CularS/NanoVoltmeter/README.md

# NanoVoltmeter
Low and high input resistance nanovoltmeter with 20 and 200 mV range
