CularS/NanoVoltmeter/InitialConcepts/nanovoltmeter_dig.pdf

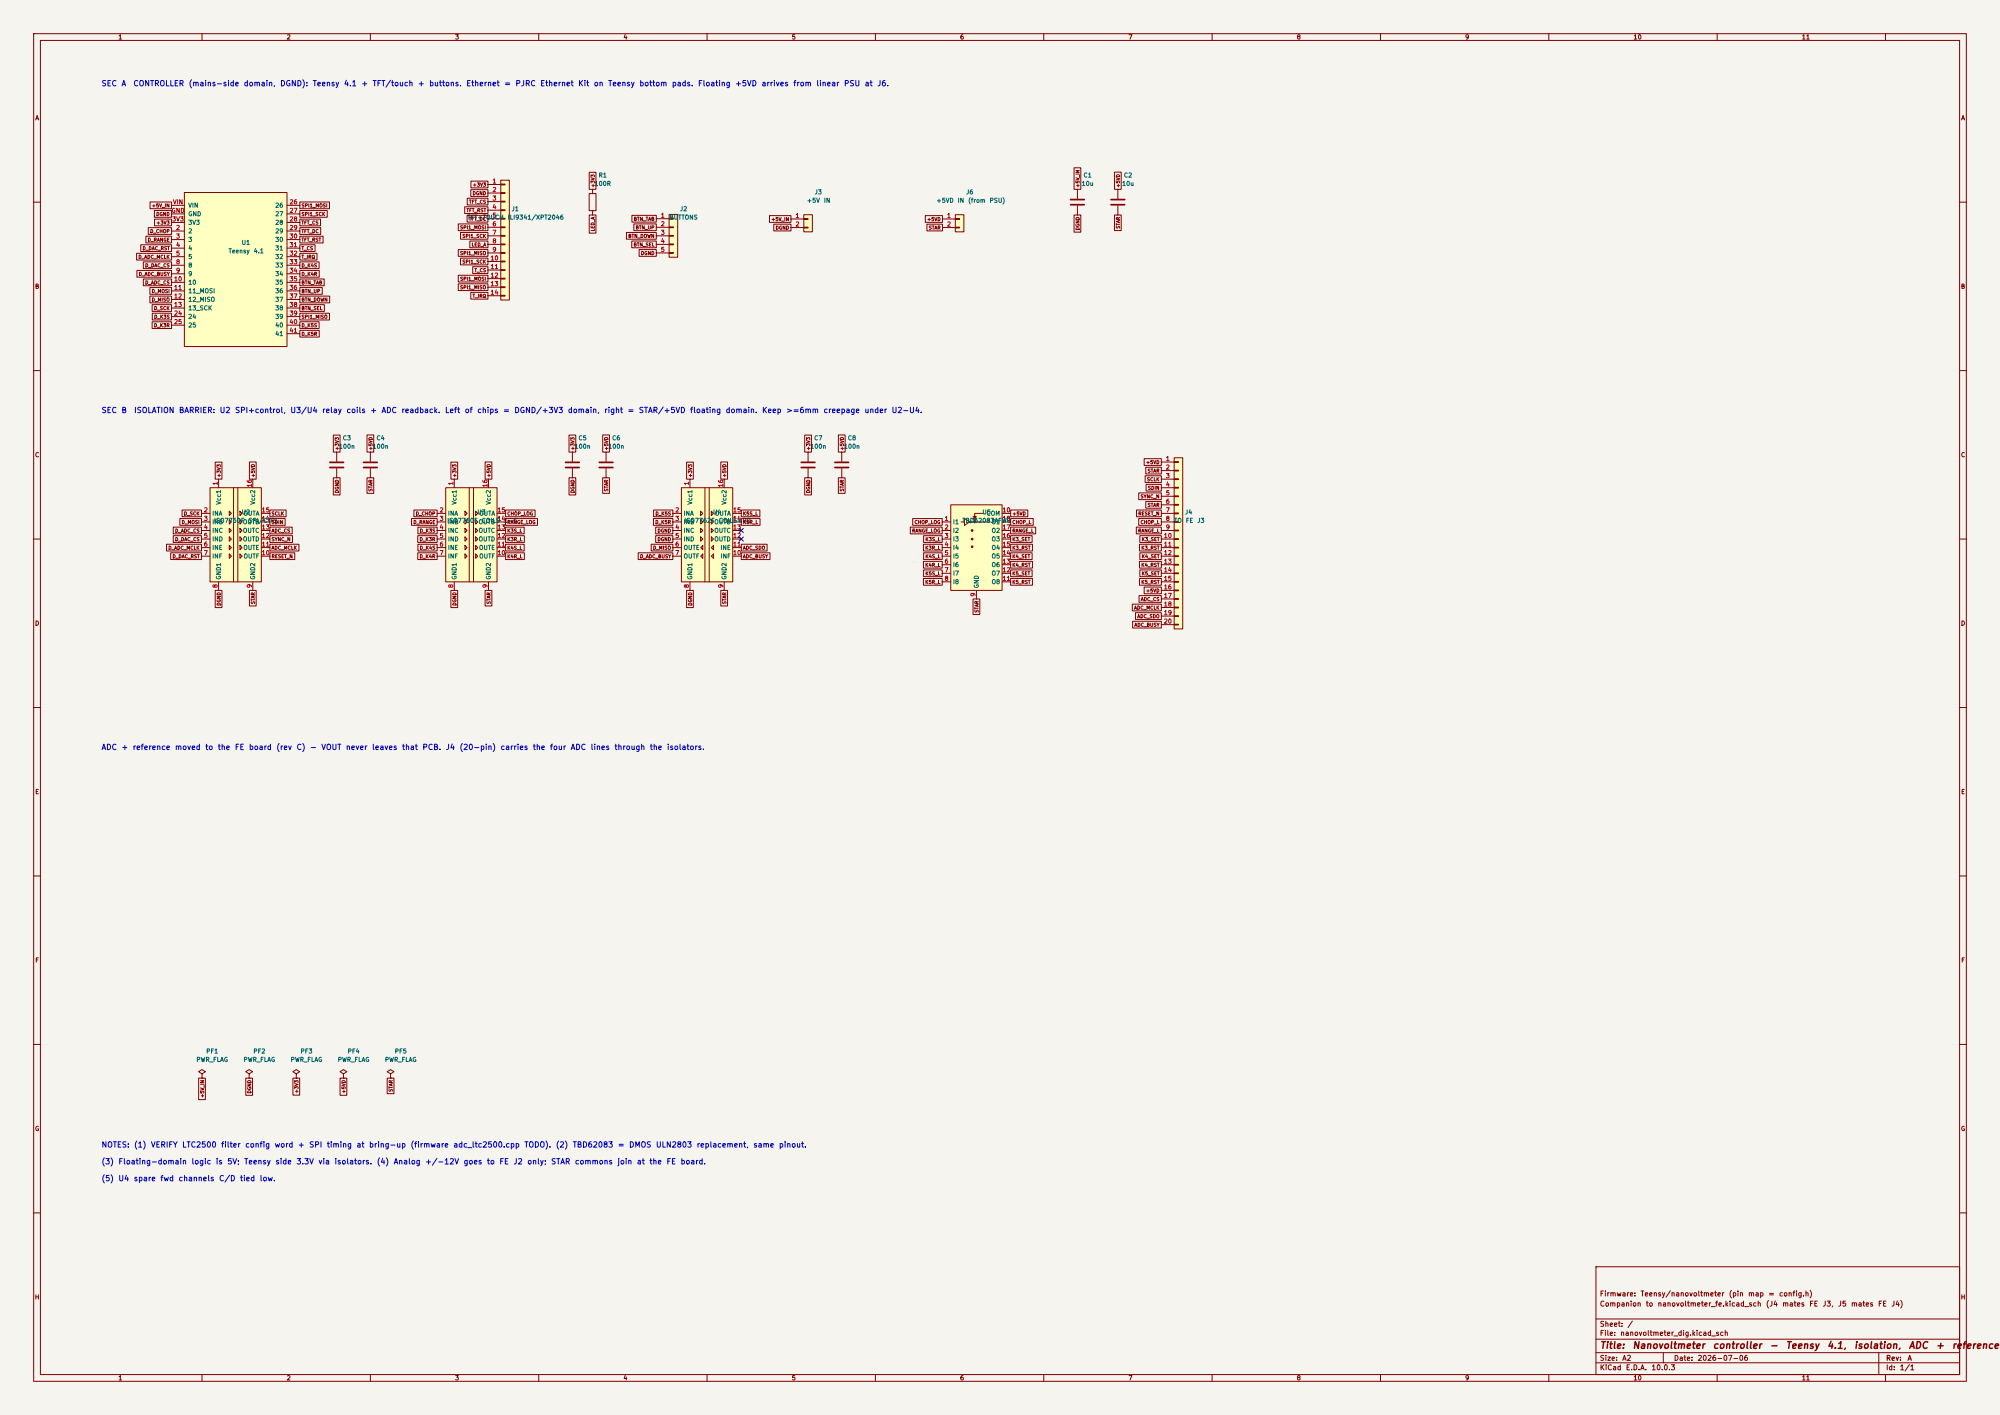
[picture p1: page 1]

SEC A CONTROLLER (mains-side domain, DGND): Teensy 4.1 + TFT/touch + buttons. Ethernet = PJRC Ethernet Kit on Teensy bottom pads. Floating +5VD arrives from linear PSU at J6.

SEC B ISOLATION BARRIER: U2 SPI+control, U3/U4 relay coils + ADC readback. Left of chips = DGND/+3V3 domain, right = STAR/+5VD floating domain. Keep >=6mm creepage under U2-U4.

9 OUTF 10 OUTE 11 OUTD 12 OUTC 13 OUTB 14 OUTA 15 Vcc2 16 U2

9 OUTF 10 OUTE 11 OUTD 12 OUTC 13 OUTB 14 OUTA 15 Vcc2 16 U3

INF 10 INE 11 OUTD 12 OUTC 13 OUTB 14 OUTA 15 Vcc2 16 U4

K5_RST K5_SET K4_RST NOTES: (1) VERIFY LTC2500 filter config word + SPI timing at bring-up (firmware adc_ltc2500.cpp TODO). (2) TBD62083 = DMOS ULN2803 replacement, same pinout.

ADC + reference moved to the FE board (rev C) - VOUT never leaves that PCB. J4 (20-pin) carries the four ADC lines through the isolators.

Firmware: Teensy/nanovoltmeter (pin map = config.h) PF3 PWR_FLAG

(3) Floating-domain logic is 5V; Teensy side 3.3V via isolators. (4) Analog +/-12V goes to FE J2 only; STAR commons join at the FE board.

(5) U4 spare fwd channels C/D tied low.

Companion to nanovoltmeter_fe.kicad_sch (J4 mates FE J3, J5 mates FE J4)

Sheet: /
File: nanovoltmeter_dig.kicad_sch
Title: Nanovoltmeter controller - Teensy 4.1, isolation, ADC + reference

Size: A2 | Rev: A
KiCad E.D.A. 10.0.3 | Id: 1/1
