CularS/NanoVoltmeter/InitialConcepts/nanovoltmeter_fe.pdf

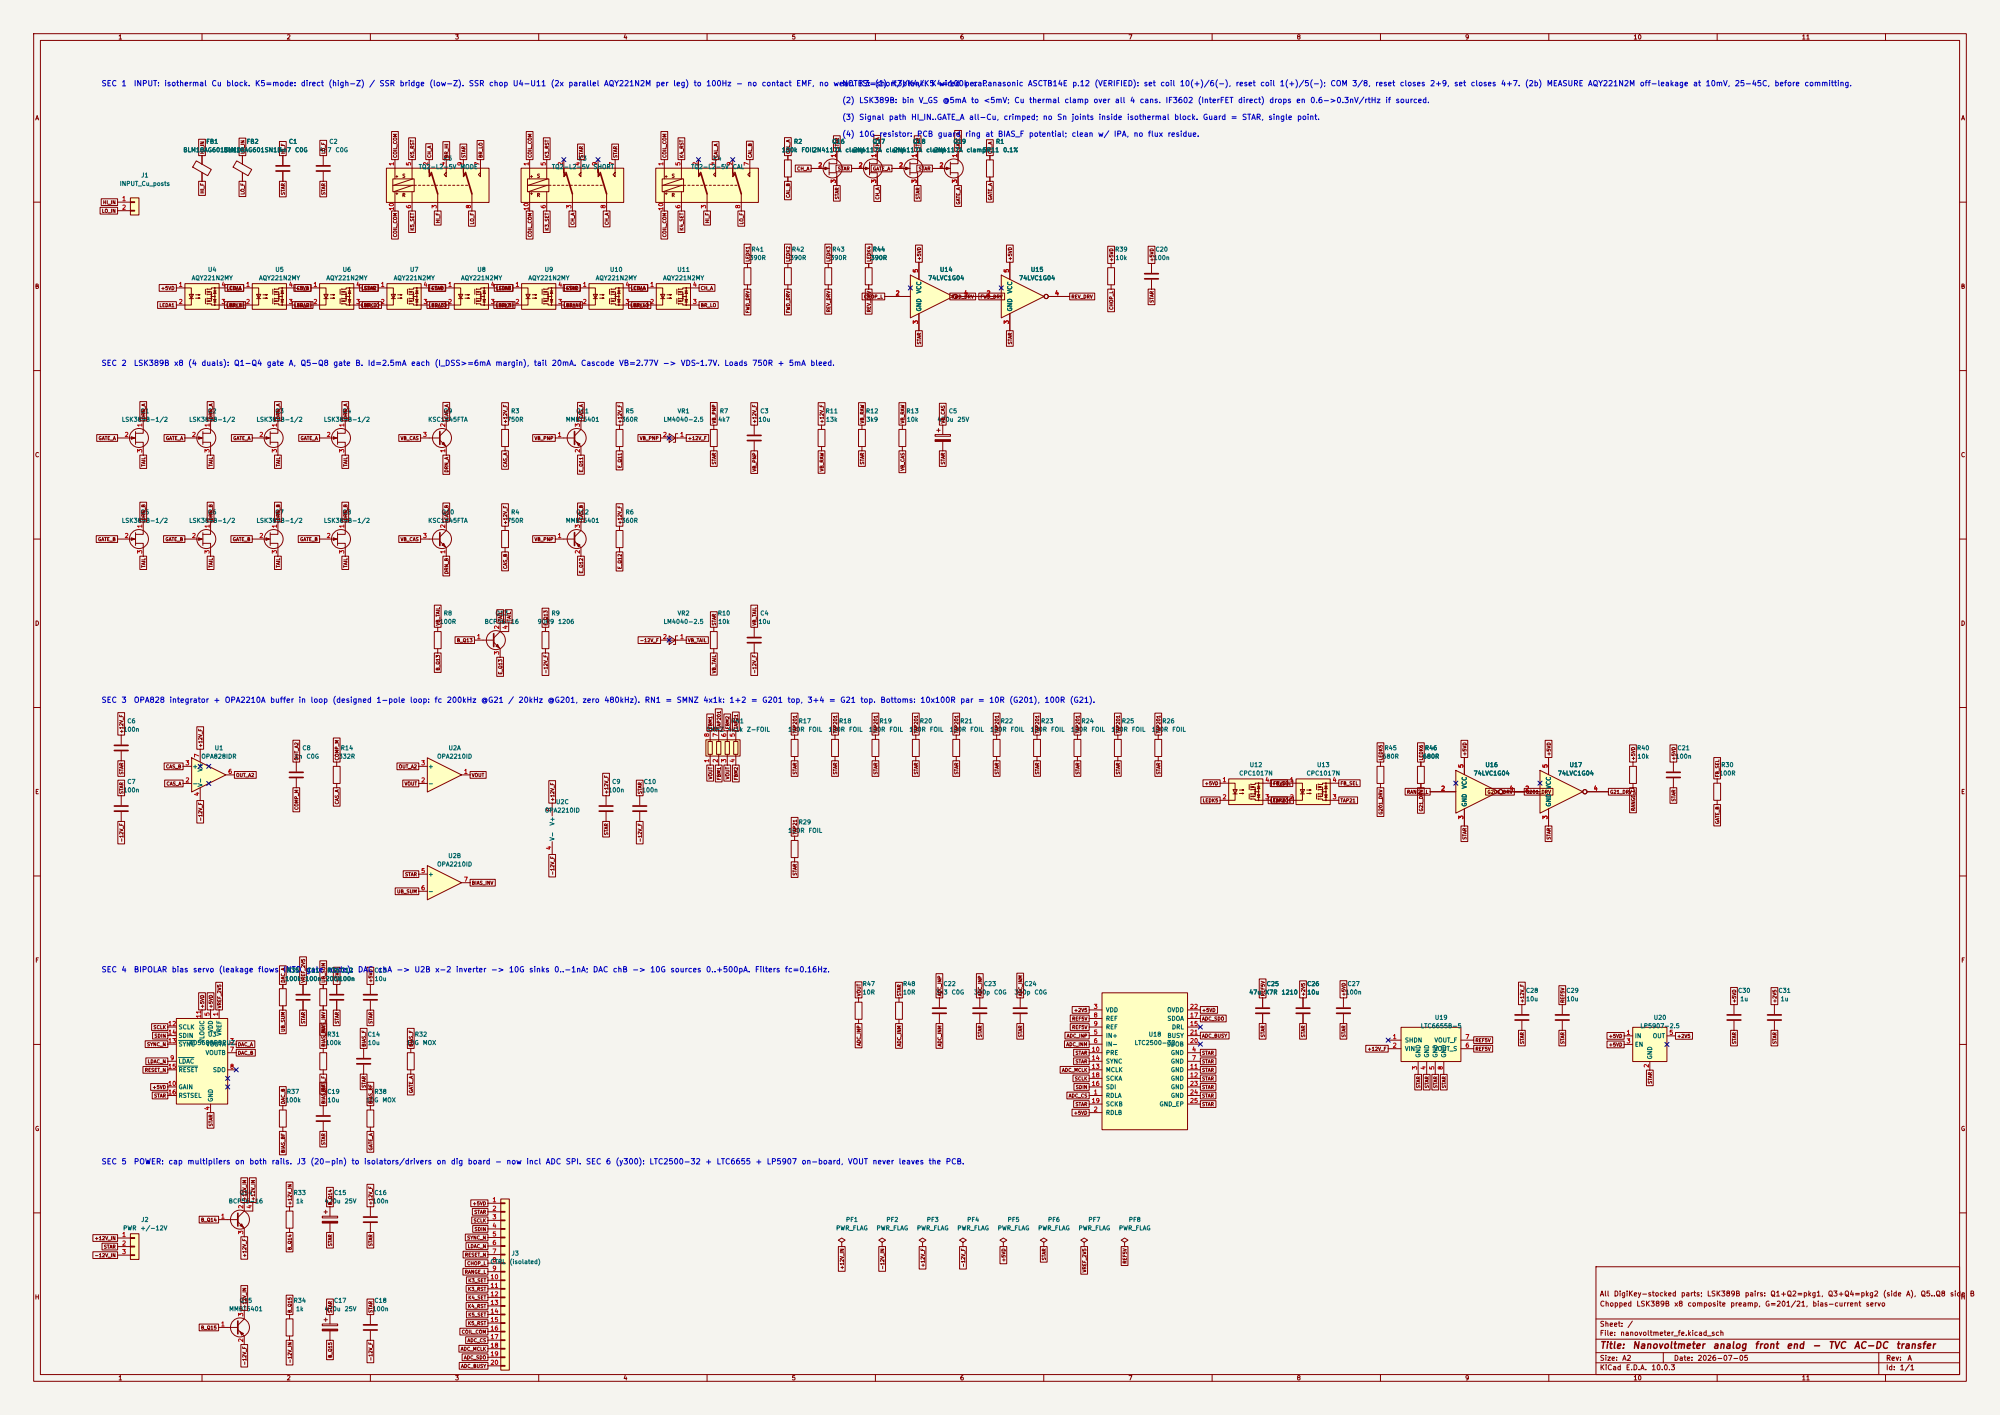
[picture p2: page 1]

SEC 1 INPUT: isothermal Cu block. K5=mode: direct (high-Z) / SSR bridge (low-Z). SSR chop U4-U11 (2x parallel AQY221N2M per leg) to 100Hz - no contact EMF, no wear. K3=short/blank. K4=100k cal.

NOTES: (1) K3/K4/K5 wired per Panasonic ASCTB14E p.12 (VERIFIED): set coil 10(+)/6(-), reset coil 1(+)/5(-); COM 3/8, reset closes 2+9, set closes 4+7. (2b) MEASURE AQY221N2M off-leakage at 10mV, 25-45C, before committing.
74LVC1G04 R1

(2) LSK389B: bin V_GS @5mA to <5mV; Cu thermal clamp over all 4 cans. IF3602 (InterFET direct) drops en 0.6->0.3nV/rtHz if sourced.

(3) Signal path HI_IN..GATE_A all-Cu, crimped; no Sn joints inside isothermal block. Guard = STAR, single point.

SEC 2 LSK389B x8 (4 duals): Q1-Q4 gate A, Q5-Q8 gate B. Id=2.5mA each (I_DSS>=6mA margin), tail 20mA. Cascode VB=2.77V -> VDS~1.7V. Loads 750R + 5mA bleed.

SEC 5 POWER: cap multipliers on both rails. J3 (20-pin) to isolators/drivers on dig board - now incl ADC SPI. SEC 6 (y300): LTC2500-32 + LTC6655 + LP5907 on-board, VOUT never leaves the PCB.

All DigiKey-stocked parts; LSK389B pairs: Q1+Q2=pkg1, Q3+Q4=pkg2 (side A), Q5..Q8 side B
Chopped LSK389B x8 composite preamp, G=201/21, bias-current servo

Sheet: /
File: nanovoltmeter_fe.kicad_sch
Title: Nanovoltmeter analog front end - TVC AC-DC transfer
KiCad E.D.A. 10.0.3
