CularS/NanoVoltmeter/NVM_FrontEnd_v1/NVM_FrontEnd_v1.kicad_pcb

## KiCad design NVM_FrontEnd_v1/NVM_FrontEnd_v1.kicad_pcb (2026-07-14)

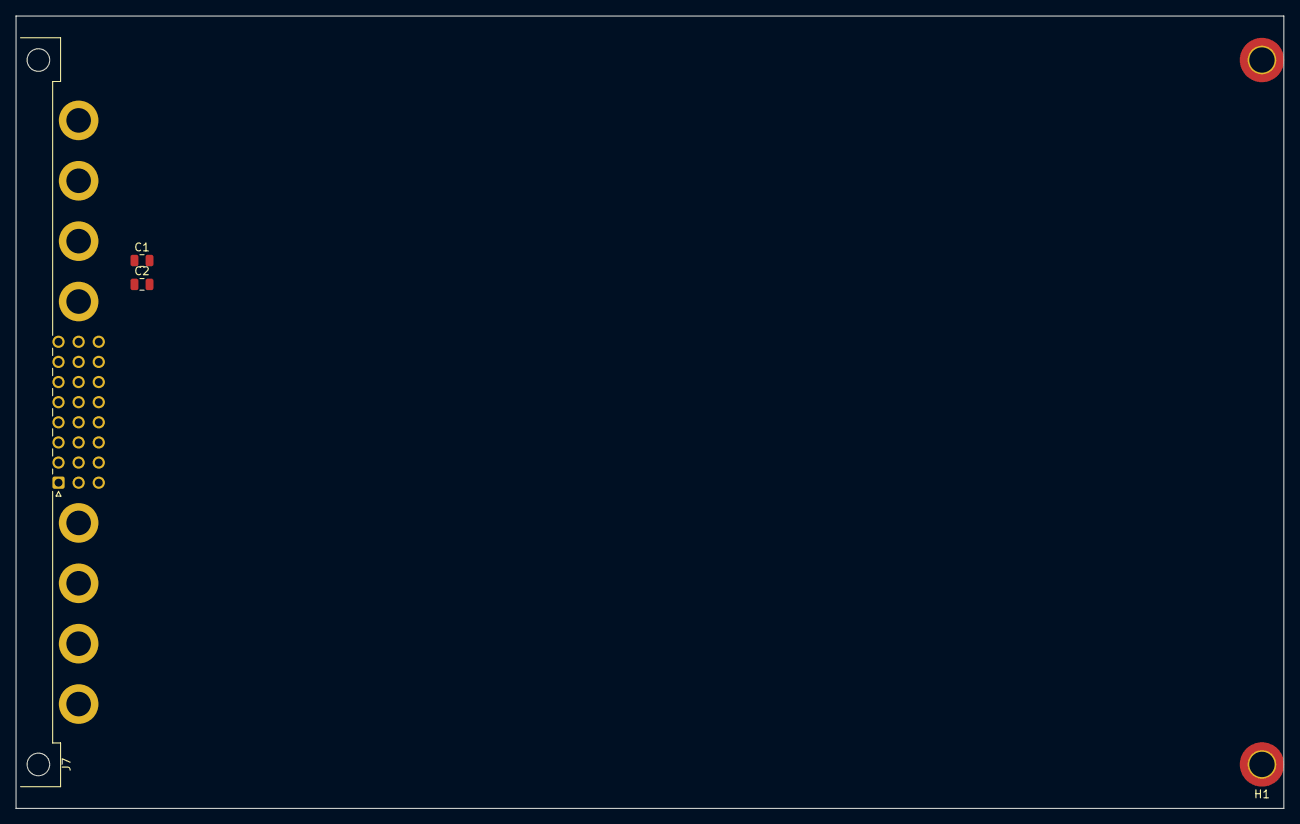
[picture p4: board NVM_FrontEnd_v1.kicad_pcb from above]

Board: 2 copper layers, 160.0 x 100.0 mm, 5 parts (0 on the bottom side), 5 nets, no tracks yet.

Parts:
C1, C2: 10u; C_0805_2012Metric
H1, H3: MountingHole_Pad; MountingHole_3.2mm_M3_DIN965_Pad_TopBottom
J7: DIN41612_M_3x8+8_Power_Male; DIN41612_M_3x8+8_Male_Horizontal_THT_Power

Connections:
+5V_An: C2.1, J7.P3
+5V_Dig: C1.1, J7.P7
DGND: C1.2, J7.P6, J7.P8
Earth: H1.1 (1_1), H3.1 (1_1)
STAR: C2.2, J7.P2, J7.P5
