CularS/NanoVoltmeter/NVM_Digital_v1/NVM_Digital_v1.kicad_pcb

## KiCad design NVM_Digital_v1/NVM_Digital_v1.kicad_pcb (2026-07-08)

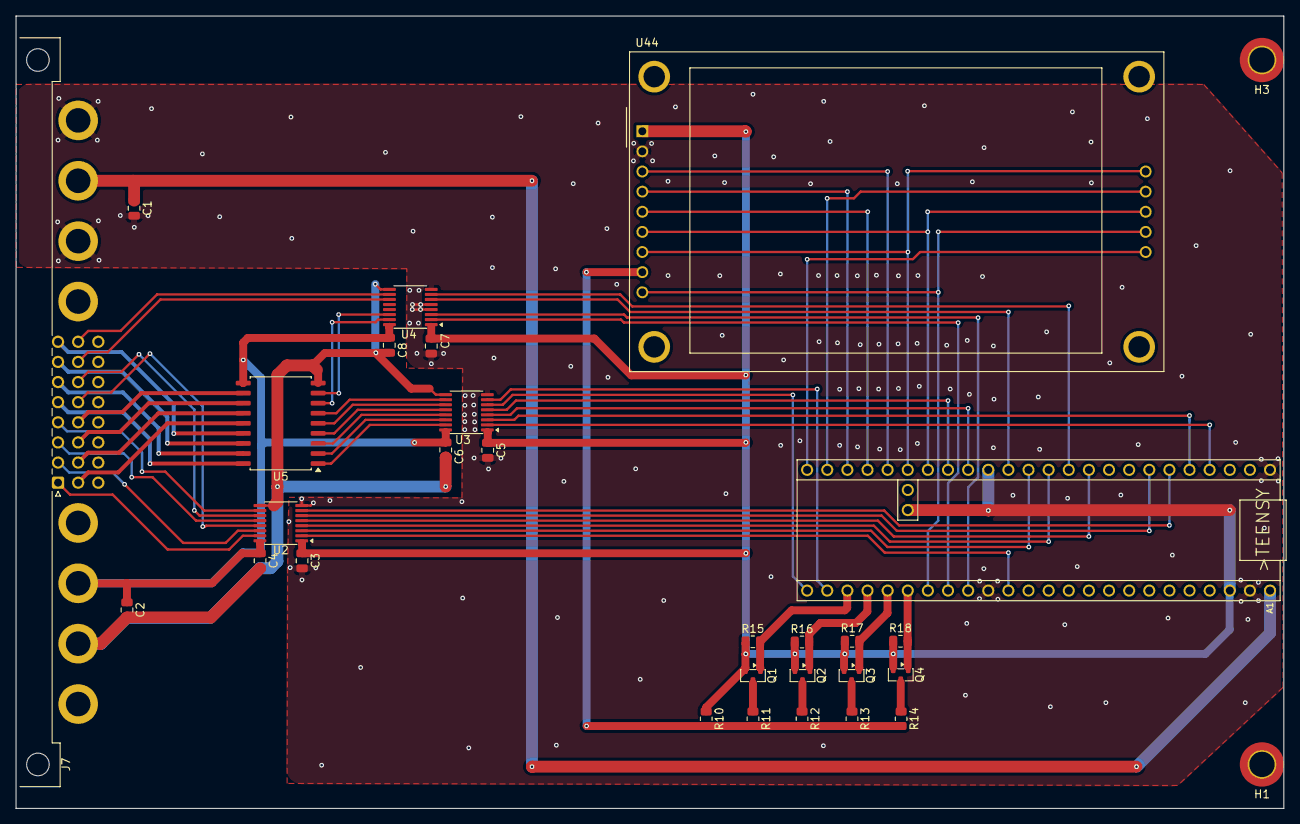
[picture p5: board NVM_Digital_v1.kicad_pcb from above]

Board: 2 copper layers, 160.0 x 100.0 mm, 30 parts (0 on the bottom side), 63 nets.

Parts:
A1: TEENSY_4.1; TEENSY_LONG_EXT
C1, C2: 10u; C_0805_2012Metric
C3, C4, C5, C6, C7, C8: 100n; C_0805_2012Metric
H1, H3: MountingHole_Pad; MountingHole_3.2mm_M3_DIN965_Pad_TopBottom
J7: DIN41612_M_3x8+8_Power_Male; DIN41612_M_3x8+8_Male_Horizontal_THT_Power
Q1, Q2, Q3, Q4: DMG3415U; SOT-23
R10: 330R; R_0805_2012Metric
R11: 150R; R_0805_2012Metric
R12: 68R; R_0805_2012Metric
R13: 33R; R_0805_2012Metric
R14: 15R; R_0805_2012Metric
R15, R16, R17, R18: 100k; R_0805_2012Metric
U2: ISO7760F SPI/CTRL; QSOP-16_3.9x4.9mm_P0.635mm
U3: ISO7760F COILS 1-6; QSOP-16_3.9x4.9mm_P0.635mm
U4: ISO7762F COILS+RD; QSOP-16_3.9x4.9mm_P0.635mm
U5: TBD62083AFWG; SOP-18_7.495x11.515mm_P1.27mm
U44: CR2013-MI2120

Connections:
+3V3: A1.3V3 (3.3V), A1.3V3@2 (3.3V), A1.3V3@3 (3.3V), C3.1, C5.1, C7.1, Q1.2 (S), Q2.2 (S), Q3.2 (S), Q4.2 (S), R10.1, R15.1, R16.1, R17.1, R18.1, U2.1 (Vcc1), U3.1 (Vcc1), U4.1 (Vcc1), U44.1 (VCC)
+5V_An: C2.1, C4.1, C6.1, C8.1, J7.P3, U2.16 (Vcc2), U3.16 (Vcc2), U4.16 (Vcc2), U5.10 (COM)
+5V_Dig: A1.VIN, C1.1, J7.P7
ADC_BUSY: J7.b20, U4.10 (INF)
ADC_CS: J7.b17, U2.13 (OUTC)
ADC_MCLK: J7.b18, U2.11 (OUTE)
ADC_SDO: J7.b19, U4.11 (INE)
CHOP_L: J7.a17, U5.18 (O1)
CHOP_LOG: U3.15 (OUTA), U5.1 (I1)
DGND: A1.AGND/GND (GND), A1.GND, A1.GND@2 (GND), C1.2, C3.2, C5.2, C7.2, J7.P6, J7.P8, U2.8 (GND1), U3.8 (GND1), U4.4 (INC), U4.5 (IND), U4.8 (GND1), U44.2 (GND)
D_ADC_BUSY: A1.D9, U4.7 (OUTF)
D_ADC_CS: A1.D10 ((CS)D10), U2.4 (INC)
D_ADC_MCLK: A1.D5, U2.6 (INE)
D_BL1: A1.D35, Q1.1 (G), R15.2
D_BL2: A1.D36, Q2.1 (G), R16.2
D_BL3: A1.D37, Q3.1 (G), R17.2
D_BL4: A1.D38 (A14), Q4.1 (G), R18.2
D_CHOP: A1.D2, U3.2 (INA)
D_DAC_CS: A1.D8, U2.5 (IND)
D_DAC_RST: A1.D4, U2.7 (INF)
D_K3R: A1.D25 (A11), U3.5 (IND)
D_K3S: A1.D24 (A10), U3.4 (INC)
D_K4R: A1.D34, U3.7 (INF)
D_K4S: A1.D33, U3.6 (INE)
D_K5R: A1.D41 (A17), U4.3 (INB)
D_K5S: A1.D40 (A16), U4.2 (INA)
D_MISO: A1.D12 ((SDI)D12), U4.6 (OUTE)
D_MOSI: A1.D11 ((SDO)D11), U2.3 (INB)
D_RANGE: A1.D3, U3.3 (INB)
D_SCK: A1.D13 ((CLK)D13), U2.2 (INA)
Earth: H1.1 (1_1), H3.1 (1_1)
K3R_L: U3.12 (OUTD), U5.4 (I4)
K3S_L: U3.13 (OUTC), U5.3 (I3)
K3_RST: J7.a20, U5.15 (O4)
K3_SET: J7.a19, U5.16 (O3)
K4R_L: U3.10 (OUTF), U5.6 (I6)
K4S_L: U3.11 (OUTE), U5.5 (I5)
K4_RST: J7.b14, U5.13 (O6)
K4_SET: J7.b13, U5.14 (O5)
K5R_L: U4.14 (OUTB), U5.8 (I8)
K5S_L: U4.15 (OUTA), U5.7 (I7)
K5_RST: J7.b16, U5.11 (O8)
K5_SET: J7.b15, U5.12 (O7)
unnamed: Q1.3 (D), R11.1
unnamed: Q2.3 (D), R12.1
unnamed: Q3.3 (D), R13.1
unnamed: Q4.3 (D), R14.1
unnamed: R10.2, R11.2, R12.2, R13.2, R14.2, U44.8 (LED)
RANGE_L: J7.a18, U5.17 (O2)
RANGE_LOG: U3.14 (OUTB), U5.2 (I2)
RESET_N: J7.a16, U2.10 (OUTF)
SCLK: J7.a13, U2.15 (OUTA)
SDIN: J7.a14, U2.14 (OUTB)
SPI1_MISO: A1.D39 (A15), U44.9 (MISO), U44.13 (T_DO)
SPI1_MOSI: A1.D26 (A12), U44.6 (MOSI), U44.12 (T_DIN)
SPI1_SCK: A1.D27 (A13), U44.7 (SCK), U44.10 (T_CLK)
STAR: C2.2, C4.2, C6.2, C8.2, J7.P2, J7.P5, U2.9 (GND2), U3.9 (GND2), U4.9 (GND2), U5.9 (GND)
SYNC_N: J7.a15, U2.12 (OUTD)
TFT_CS: A1.D28, U44.3 (~CS)
TFT_DC: A1.D29, U44.5 (D/~C)
TFT_RST: A1.D30, U44.4 (RESET)
T_CS: A1.D31, U44.11 (T_CS)
T_IRQ: A1.D32, U44.14 (T_IRQ)
