CularS/NanoVoltmeter/NVM_PSU_v1/NVM_PSU_v1.kicad_pcb

## KiCad design NVM_PSU_v1/NVM_PSU_v1.kicad_pcb (2026-07-08)

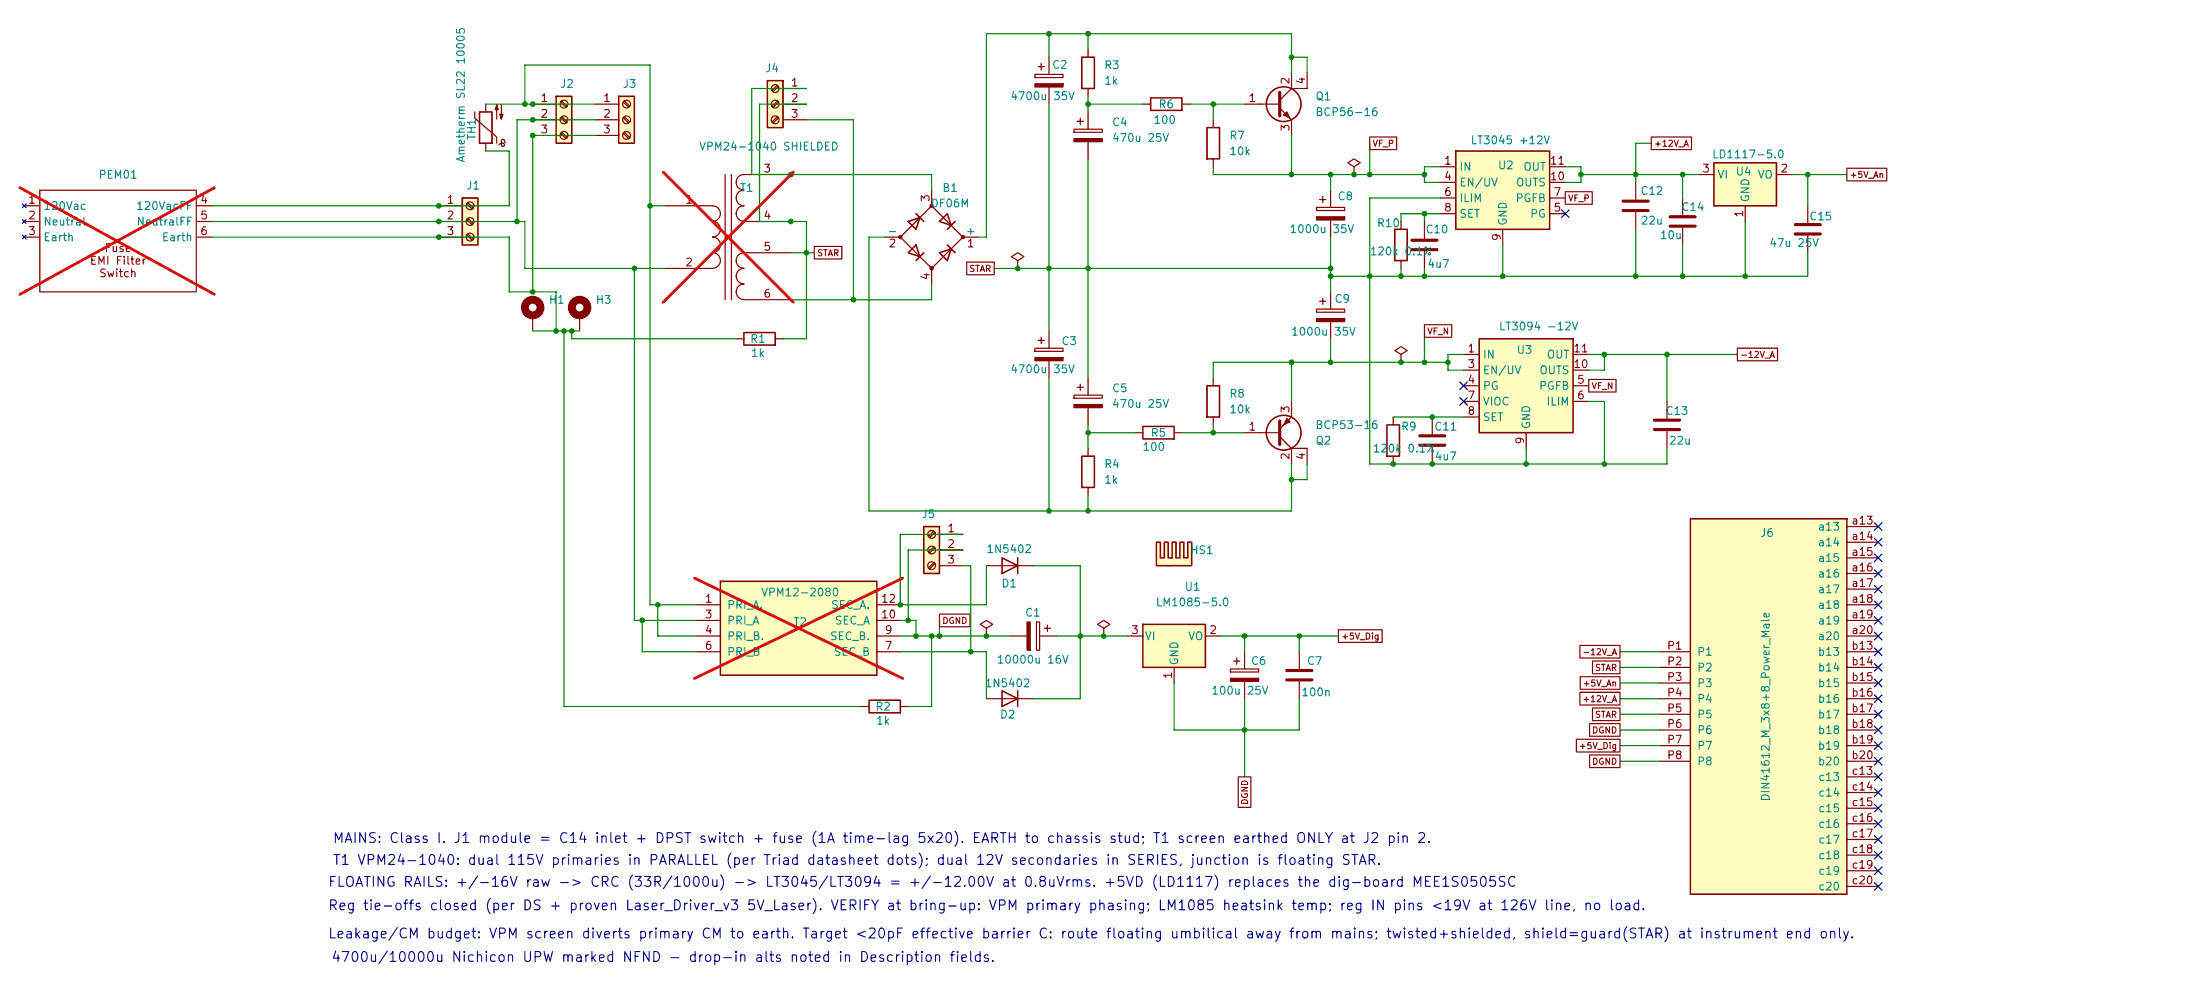
[picture p6: schematic NVM_PSU_v1.kicad_sch]

Parts:
B1: DF06M; Diode_Bridge_DIP-4_W7.62mm_P5.08mm; MPN DF06M-E3/45; DigiKeyPN DF06M-E3/45GICT-ND
C1: 10000u 16V; CP_Radial_D18.0mm_P7.50mm; MPN UPW1C103MHD; DigiKeyPN 493-1638-ND
C2, C3: 4700u 35V; CP_Radial_D18.0mm_P7.50mm; MPN UPW1V472MHD; DigiKeyPN 493-1653-ND
C4, C5: 470u 25V; CP_Radial_D10.0mm_P5.00mm; MPN ECA-1EM471
C6: 100u 25V; CP_Radial_D8.0mm_P3.50mm; MPN UPW1E101MED; DigiKeyPN 493-1548-ND
C7: 100n; C_0805_2012Metric; MPN GRM21BR71H104KA01L
C8, C9: 1000u 35V; CP_Radial_D12.5mm_P5.00mm; MPN UPW1V102MHD; DigiKeyPN 493-1645-ND
C10, C11: 4u7; C_0805_2012Metric; MPN GRM21BR71E475KE13L
C12, C13: 22u; C_0805_2012Metric; MPN GRM21BR61E226ME44L
C14: 10u; C_0805_2012Metric; MPN GRM21BR61E106KA73L
C15: 47u 25V; CP_Radial_D5.0mm_P2.00mm; MPN ECA-1EM470
D1, D2: 1N5402; D_DO-201AD_P12.70mm_Horizontal; MPN 1N5402G; DigiKeyPN 1N5402GOS-ND
H1, H3: MountingHole_Pad; MountingHole_3.2mm_M3_DIN965_Pad_TopBottom
HS1: AAVID 531102B02500G; Heatsink_AAVID_Extruded_531102B02500G_34.9x12.7mm_H38.1mm; MPN 531102B02500G; DigiKeyPN HS352-ND
J1, J2, J3, J4, J5: Screw_Terminal_01x03; TerminalBlock_Phoenix_MKDS-1,5-3-5.08_1x03_P5.08mm_Horizont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; MPN 1729131
J6: DIN41612_M_3x8+8_Power_Male; DIN41612_M_3x8+8_Male_Horizontal_THT_Power
PEM01: not fitted
Q1: BCP56-16; SOT-223; MPN BCP56-16TF
Q2: BCP53-16; SOT-223; MPN BCP53-16TF
R1, R2, R3, R4: 1k; R_0805_2012Metric_Pad1.20x1.40mm_HandSolder; MPN CRCW08051K00FKEA
R5, R6: 100; R_0805_2012Metric_Pad1.20x1.40mm_HandSolder; MPN RC0805FR-07100RL
R7, R8: 10k; R_0805_2012Metric_Pad1.20x1.40mm_HandSolder; MPN RC0805FR-0710KL
R9, R10: 120k 0.1%; R_0805_2012Metric; MPN RT0805BRD07120KL
T1: VPM24-1040 SHIELDED; WirePad_1x06_P7.62; MPN VPM24-1040; DigiKeyPN 237-2025-ND; not fitted
T2: VPM12-2080; MPN VPM12-2080; DigiKeyPN 237-2023-ND; not fitted
TH1: Ametherm SL22 10005; R_Axial_DIN0411_L9.9mm_D3.6mm_P7.62mm_Vertical
U1: LM1085-5.0; TO-220-3_Vertical; MPN LM1085IT-5.0/NOPB; DigiKeyPN LM1085IT-5.0/NOPB-ND
U2: LT3045 +12V; MSOP-12-1EP_3x4.039mm_P0.65mm_EP1.651x2.845mm; MPN LT3045EMSE#PBF; DigiKeyPN LT3045EMSE#PBF-ND
U3: LT3094 -12V; MSOP-12-1EP_3x4.039mm_P0.65mm_EP1.651x2.845mm; MPN LT3094EMSE#TRPBF; DigiKeyPN LT3094EMSE#TRPBF-ND
U4: LD1117-5.0; SOT-223-3_TabPin2; MPN LD1117S50TR; DigiKeyPN 497-1440-2-ND

Connections:
+5V_An: C15.1, J6.P3, U4.2 (VO)
+5V_Dig: C6.1, C7.1, J6.P7, U1.2 (VO)
+12V_A: C12.1, C14.1, J6.P4, U2.10 (OUTS), U2.11 (OUT), U2.12 (OUT), U4.3 (VI)
-12V_A: C13.1, J6.P1, U3.10 (OUTS), U3.11 (OUT), U3.12 (OUT)
DGND: C1.2, C6.2, C7.2, J5.2, J6.P6, J6.P8, R2.2, T2.9 (SEC_B.), T2.10 (SEC_A), U1.1 (GND)
unnamed: B1.1 (+), C2.1, Q1.2 (C), Q1.4 (C), R3.1
unnamed: B1.2 (-), C3.2, Q2.2 (C), Q2.4 (C), R4.2
unnamed: C4.1, R3.2, R6.1
unnamed: C5.2, R4.1, R5.1
unnamed: D1.2 (A), J5.1, T2.12 (SEC_A.)
unnamed: C1.1, D1.1 (K), D2.1 (K), U1.3 (VI)
unnamed: D2.2 (A), J5.3, T2.7 (SEC_B)
unnamed: J1.1, PEM01.4 (120VacFF), TH1.1
unnamed: J1.2, J2.2, J3.2, PEM01.5 (NeutralFF), T1.2 (AB), T2.3 (PRI_A), T2.6 (PRI_B)
unnamed: H1.1 (1_1), H3.1 (1_1), J1.3, J2.3, J3.3, PEM01.6 (Earth), R1.1, R2.1
unnamed: J2.1, J3.1, T1.1 (AA), T2.1 (PRI_A.), T2.4 (PRI_B.), TH1.2
unnamed: B1.3, J4.1, T1.3 (SA)
unnamed: B1.4, J4.3, T1.6 (SD)
unnamed: Q1.1 (B), R6.2, R7.1
unnamed: Q2.1 (B), R5.2, R8.2
unnamed: C10.1, R10.1, U2.8 (SET)
unnamed: C11.1, R9.1, U3.8 (SET)
STAR: C2.2, C3.1, C4.2, C5.1, C8.2, C9.1, C10.2, C11.2, C12.2, C13.2, C14.2, C15.2, J4.2, J6.P2, J6.P5, R1.2, R9.2, R10.2, T1.4 (SB), T1.5 (SC), U2.6 (ILIM), U2.9 (GND), U2.13 (GND), U3.6 (ILIM), U3.9 (GND), U4.1 (GND)
VF_N: C9.2, Q2.3 (E), R8.1, U3.1 (IN), U3.2 (IN), U3.3 (EN/UV), U3.5 (PGFB), U3.13 (IN)
VF_P: C8.1, Q1.3 (E), R7.2, U2.1 (IN), U2.2 (IN), U2.3 (IN), U2.4 (EN/UV), U2.7 (PGFB)

Notes on the sheet:
T1 VPM24-1040: dual 115V primaries in PARALLEL (per Triad datasheet dots); dual 12V secondaries in SERIES, junction is floating STAR.
4700u/10000u Nichicon UPW marked NFND - drop-in alts noted in Description fields.
MAINS: Class I. J1 module = C14 inlet + DPST switch + fuse (1A time-lag 5x20). EARTH to chassis stud; T1 screen earthed ONLY at J2 pin 2.
Leakage/CM budget: VPM screen diverts primary CM to earth. Target <20pF effective barrier C: route floating umbilical away from mains; twisted+shielded, shield=guard(STAR) at instrument end only.
FLOATING RAILS: +/-16V raw -> CRC (33R/1000u) -> LT3045/LT3094 = +/-12.00V at 0.8uVrms. +5VD (LD1117) replaces the dig-board MEE1S0505SC
Reg tie-offs closed (per DS + proven Laser_Driver_v3 5V_Laser). VERIFY at bring-up: VPM primary phasing; LM1085 heatsink temp; reg IN pins <19V at 126V line, no load.

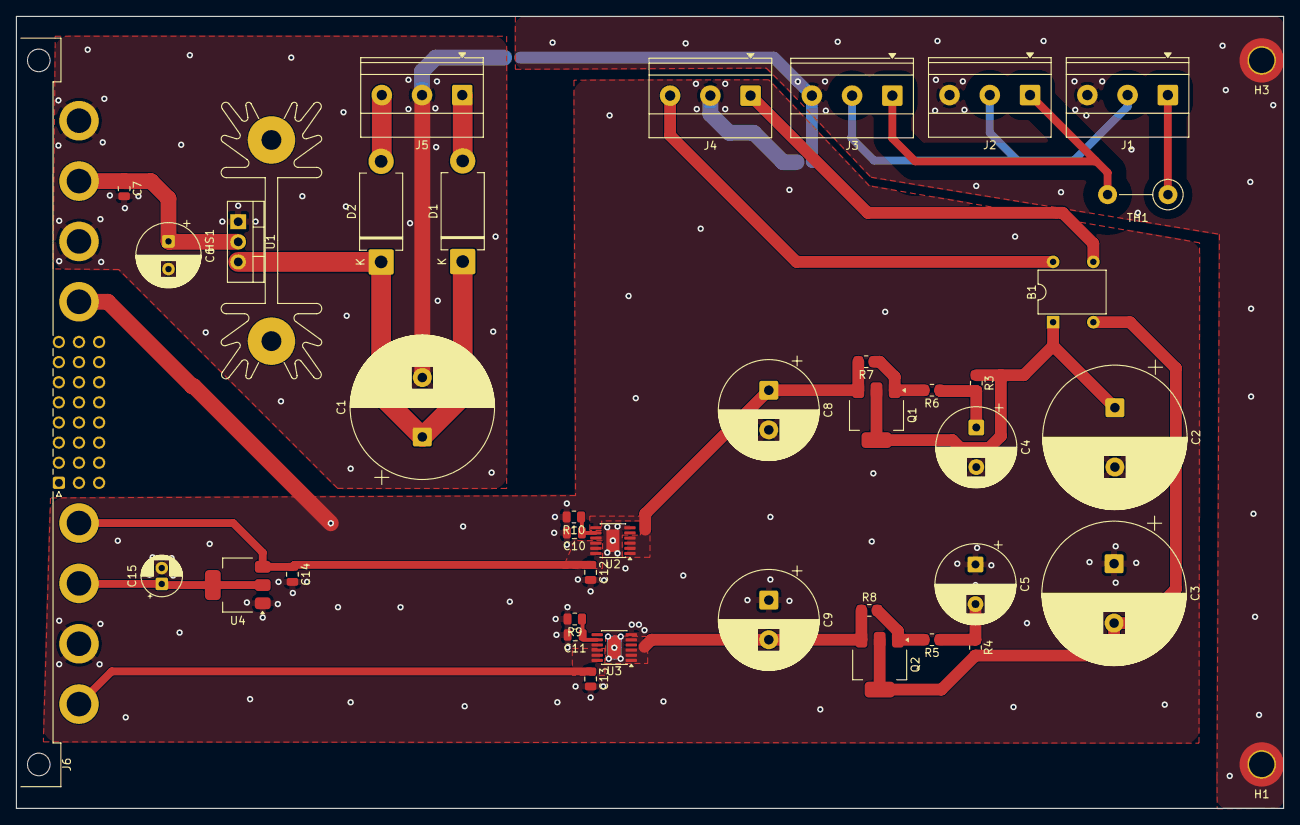
[picture p7: board NVM_PSU_v1.kicad_pcb from above]

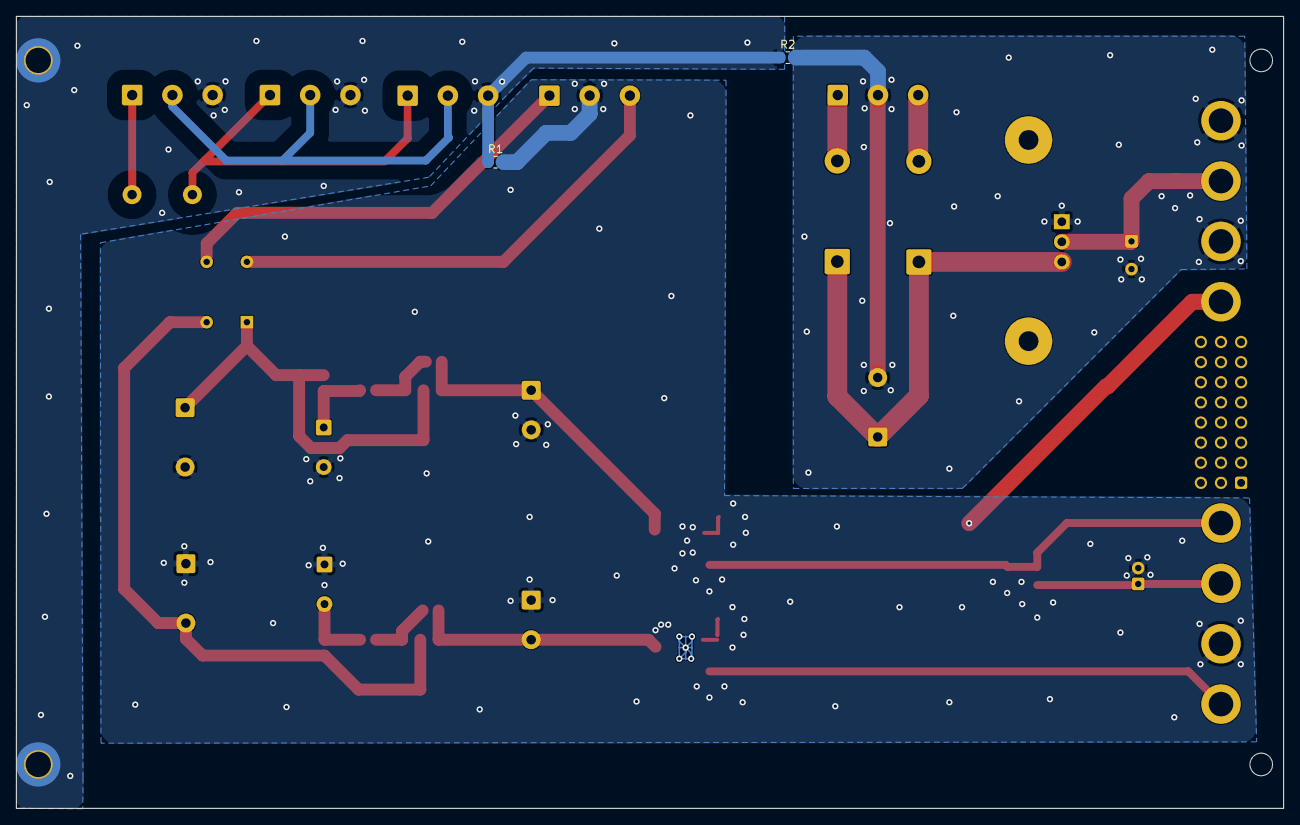
[picture p8: board NVM_PSU_v1.kicad_pcb from below]

Board: 2 copper layers, 160.0 x 100.0 mm, 44 parts (2 on the bottom side), 25 nets.
