CularS/NanoVoltmeter/(commit log)

2026-07-06 First concepts for the nanovoltmeter
    Teensy code and schematics for nanovoltmeter. Schematics need a lot of work and pcbs need to be made.
    [nanovoltmeter_dig.kicad_sch, nanovoltmeter_dig_BOM.csv, nanovoltmeter_fe.kicad_sch, nanovoltmeter_fe_BOM.csv, nanovoltmeter_psu.kicad_sch, nanovoltmeter_psu_BOM.csv]
2026-07-08 Update schematic and first layout of PSU
    [NVM_PSU_v1.kicad_pcb, NVM_PSU_v1.kicad_sch]
2026-07-08 Digital board and code updated
    Digital pcb layout first version complete.
    Code updated to remove the physical buttons and add 5 levels of brightness for the display.
    [Backlight_Addon.kicad_sch, NVM_Digital_v1.kicad_pcb, NVM_Digital_v1.kicad_sch]
2026-07-14 Working on front end protection and update teensy
    [NVM_Digital_v1.kicad_sch, NVM_FrontEnd_v1.kicad_pcb, NVM_FrontEnd_v1.kicad_sch, nanovoltmeter_fe.kicad_sch]
